anaidan/Open-Task-Light/Open Task Light/Electronics/Control Board/Control_Board/3D_Models/SMD2016.step

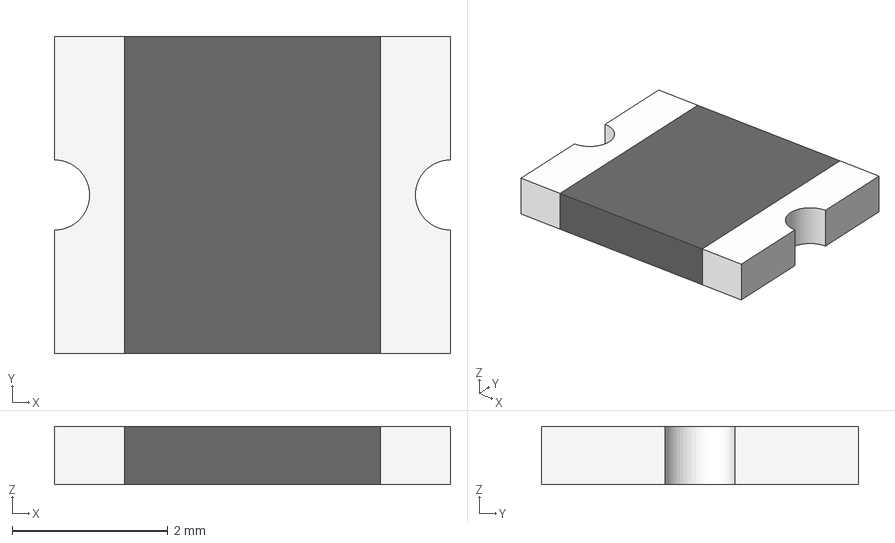
[picture p1: CAD file, 2026-11-09]
Open Task Light/Electronics/Control Board/Control_Board/3D_Models/SMD2016.step
5.08 x 4.07 x 0.75 mm
