anaidan/Open-Task-Light/Open Task Light/Electronics/Control Board/Control_Board/3D_Models/RC1206N_YAG.step

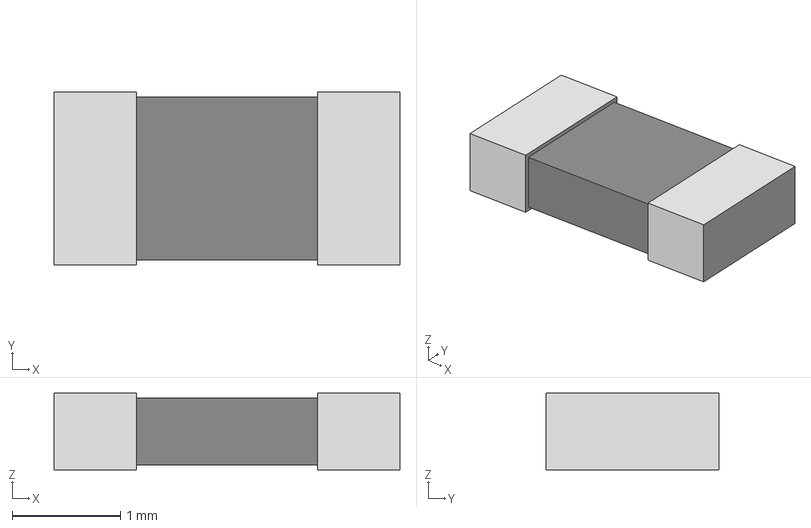
[picture p3: CAD file, 2026-10-24]
Open Task Light/Electronics/Control Board/Control_Board/3D_Models/RC1206N_YAG.step
3.20 x 1.60 x 0.711 mm
