anaidan/Open-Task-Light/Open Task Light/Electronics/Control Board/Control_Board/3D_Models/EEE-FTH101XAP.stp

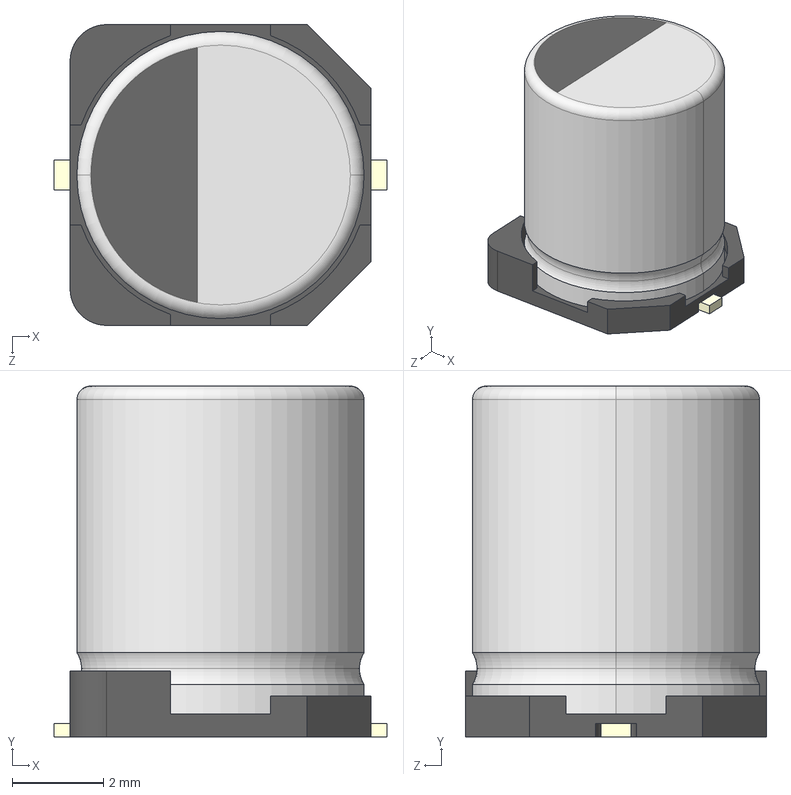
[picture p4: CAD file, 2026-10-24]
Open Task Light/Electronics/Control Board/Control_Board/3D_Models/EEE-FTH101XAP.stp
7.30 x 7.70 x 6.60 mm
標準SIZE CODE D8-001
標準SIZE CODE D8-002
標準SIZE CODE D8-003 x 2
