anaidan/Open-Task-Light/Open Task Light/Electronics/Control Board/Control_Board/3D_Models/R-78K-1.0_3D_20230223.step

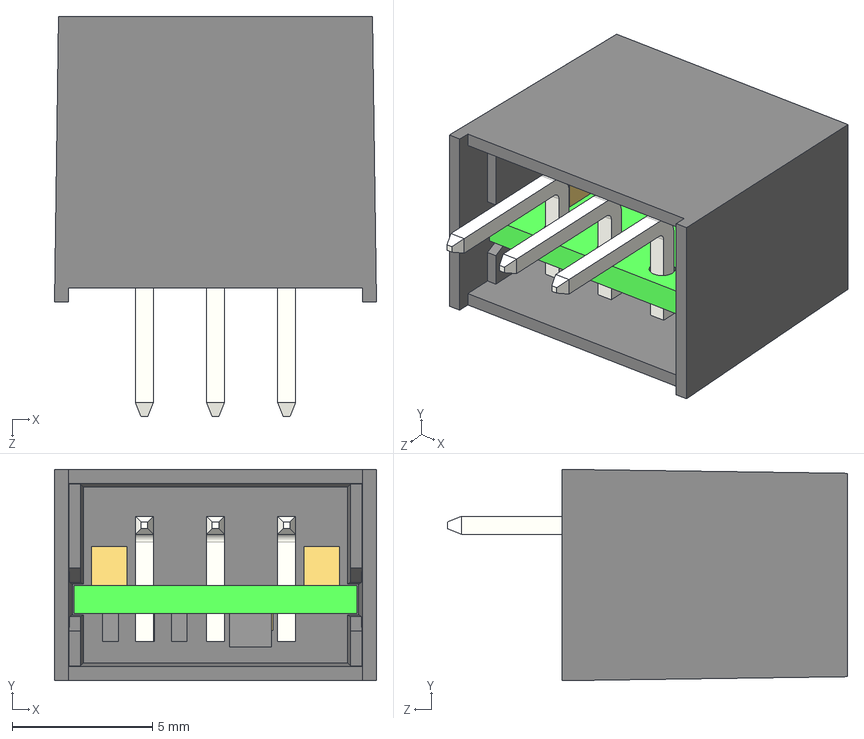
[picture p5: CAD file, 2026-10-24]
Open Task Light/Electronics/Control Board/Control_Board/3D_Models/R-78K-1.0_3D_20230223.step
11.5 x 7.55 x 14.3 mm
