anaidan/Open-Task-Light/Open Task Light/Electronics/Control Board/Control_Board/3D_Models/RCD-24-0.70VREF.stp

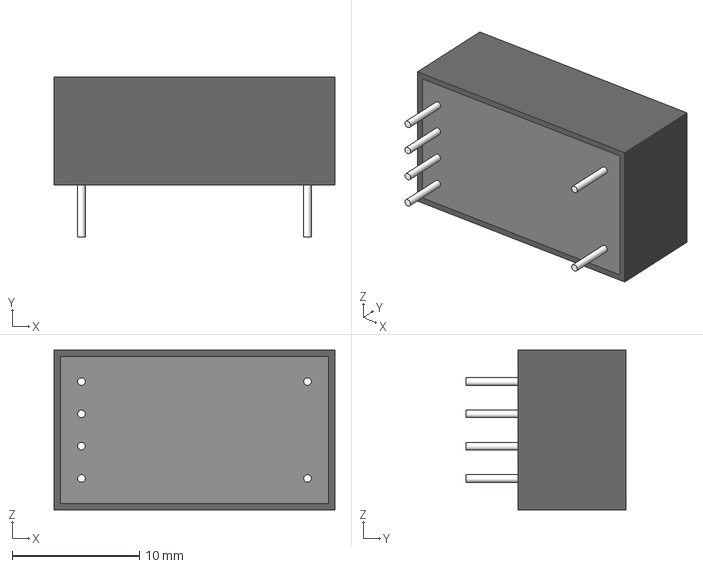
[picture p6: CAD file, 2026-10-24]
Open Task Light/Electronics/Control Board/Control_Board/3D_Models/RCD-24-0.70VREF.stp
22.1 x 12.6 x 12.6 mm
