anaidan/Open-Task-Light/Open Task Light/Electronics/Control Board/Control_Board/3D_Models/84592VEML7700.stp

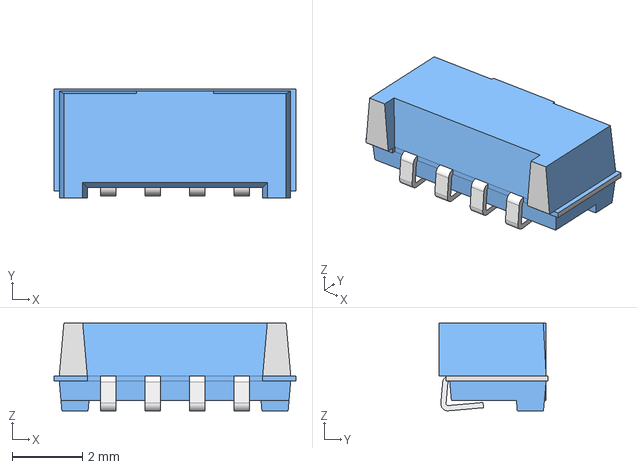
[picture p7: CAD file, 2026-10-24]
Open Task Light/Electronics/Control Board/Control_Board/3D_Models/84592VEML7700.stp
6.90 x 3.10 x 2.50 mm
