anaidan/Open-Task-Light/Open Task Light/Electronics/Control Board/Control_Board/3D_Models/2200980271.stp

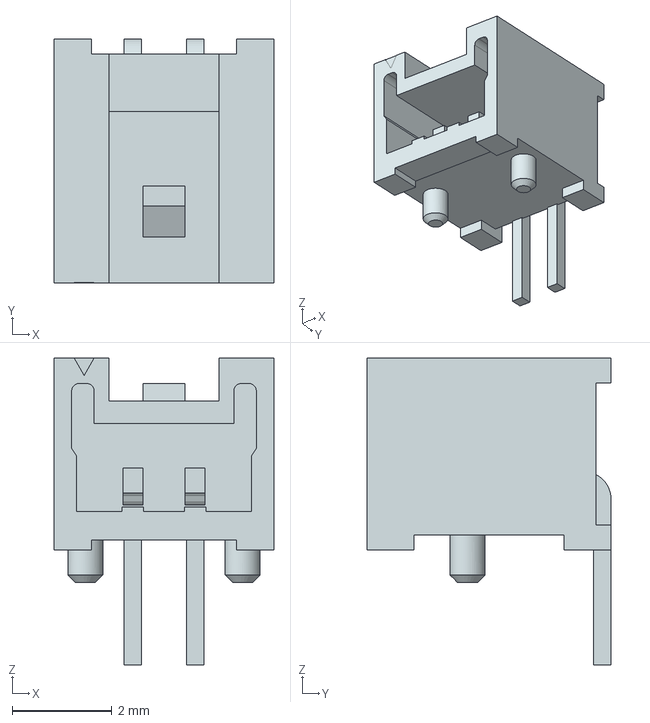
[picture p8: CAD file, 2026-10-24]
Open Task Light/Electronics/Control Board/Control_Board/3D_Models/2200980271.stp
4.40 x 4.89 x 6.15 mm
