anaidan/Open-Task-Light/Open Task Light/Electronics/Control Board/Control_Board/3D_Models/2200970271.stp

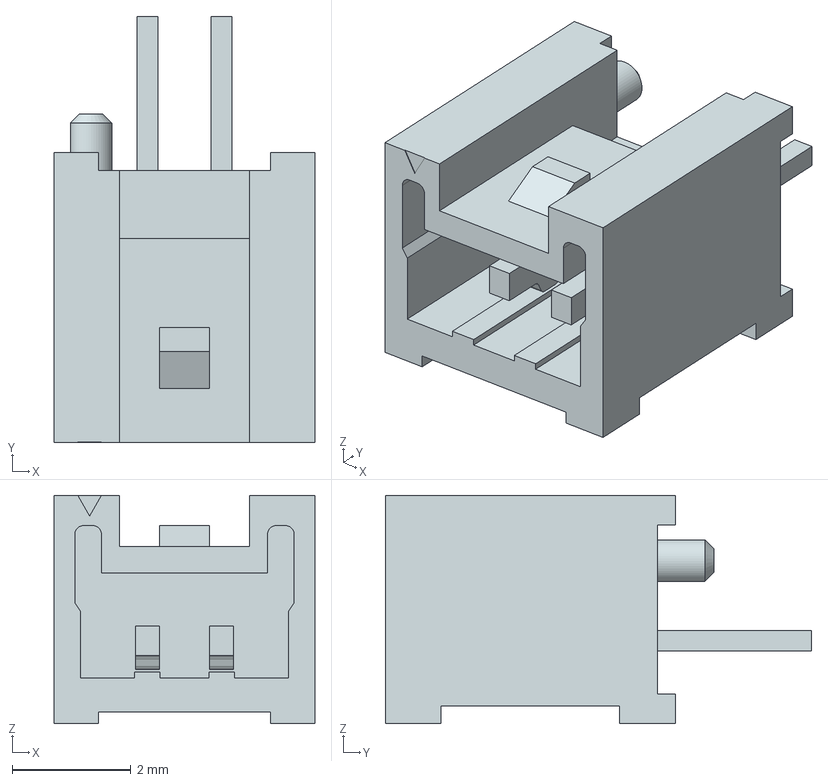
[picture p9: CAD file, 2026-10-24]
Open Task Light/Electronics/Control Board/Control_Board/3D_Models/2200970271.stp
4.40 x 7.19 x 3.85 mm
