anaidan/Open-Task-Light/Open Task Light/Electronics/Control Board/Control_Board/Control_Board.kicad_pcb

## KiCad design Open Task Light/Electronics/Control Board/Control_Board/Control_Board.kicad_pcb (2026-11-11)

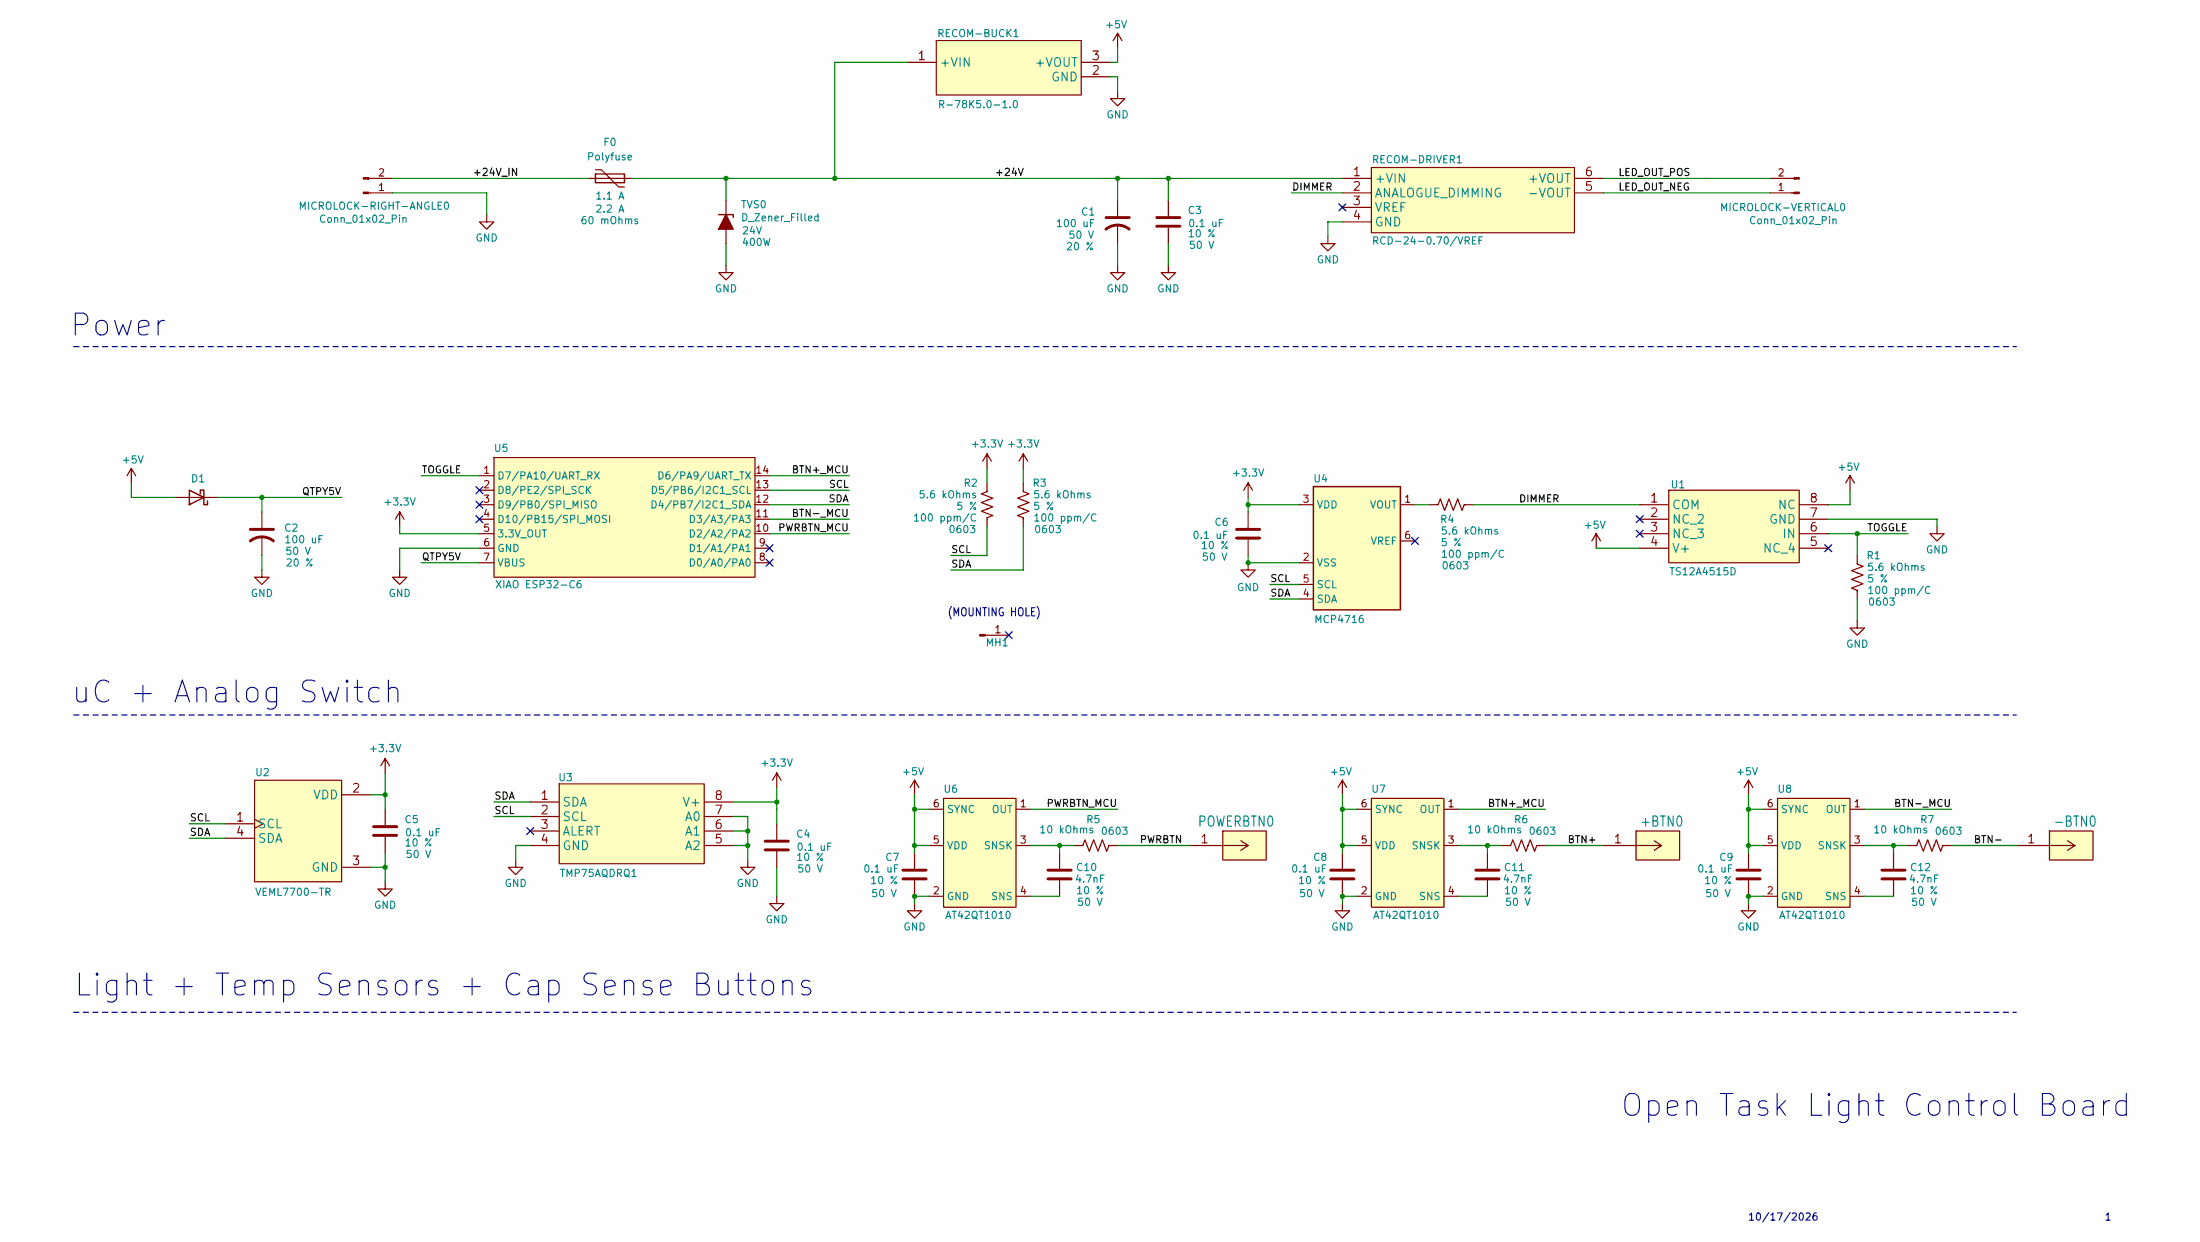
[picture p10: schematic Control_Board.kicad_sch]

Parts:
+BTN0: 807-22-001-10-001101; CONN_807-22-001-10-001101_MIM; MPN 807-22-001-10-001101
-BTN0: 807-22-001-10-001101; CONN_807-22-001-10-001101_MIM; MPN 807-22-001-10-001101
C1, C2: EEE-FTH101XAP; CAP_EEEFTH101XAP; Volage Rating 50 V; Tolerance 20 %; MPN EEE-FTH101XAP
C3, C4, C5, C6, C7, C8, C9: C; C_0603_1608Metric; Voltage Rating 50 V; Tolerance 10 %; MPN C0603C104K5RAC9109
C10, C11, C12: C; C_0603_1608Metric; Voltage Rating 50 V; Tolerance 10 %; MPN C0603C472K5RACTU
D1: 1N5819HW-7-F; D_SOD-123; MPN 1N5819HW-7-F
F0: Polyfuse; SMD2016B100TF_33; MPN SMD2016B100TF/33
MH1: 2.5MMPLATEDTHROUGHHOLE; 2.5MMPLATEDHOLE
MICROLOCK-RIGHT-ANGLE0: Conn_01x02_Pin; 2200980271; MPN 2200980271
MICROLOCK-VERTICAL0: Conn_01x02_Pin; 2200970000_A; MPN 2200970271
POWERBTN0: 807-22-001-10-001101; CONN_807-22-001-10-001101_MIM; MPN 807-22-001-10-001101
R1, R2, R3, R4: R_US; R_0603_1608Metric; Tolerance 5 %; MPN AC0603JR-075K6L
R5, R6, R7: R_US; R_0603_1608Metric; Tolerance 5 %; MPN RC0603JR-0710KL
RECOM-BUCK1: R-78K5.0-1.0; R-78K5.0-1.0_RCP; MPN R-78K5.0-1.0
RECOM-DRIVER1: RCD-24-0.70/VREF; RCD24030; MPN RCD-24-0.70/Vref
TVS0: D_Zener_Filled; SODFL3619X98N; MPN SMF4L24AT1G
U1: TS12A4515D; D8-L; MPN TS12A4515D
U2: VEML7700-TR; XDCR_VEML7700-TR; MPN VEML7700-TR
U3: TMP75AQDRQ1; D8_TEX; MPN TMP75AQDRQ1
U4: MCP4716; SOT-23-6; MPN MCP4716A3T-E/CH
U5: XIAO ESP32-C6; ESP32_C6; MPN 113991254
U6, U7, U8: AT42QT1010; SOT-23-6; MPN AT42QT1010-TSHR

Connections:
+3.3V: C4.1, C5.1, C6.1, R2.1, R3.1, U2.2 (VDD), U3.8 (V+), U4.3 (VDD), U5.5 (3.3V_OUT)
+5V: C7.1, C8.1, C9.1, D1.2 (A), RECOM-BUCK1.3 (+VOUT), U1.4 (V+), U1.8 (NC), U6.5 (VDD), U6.6 (SYNC), U7.5 (VDD), U7.6 (SYNC), U8.5 (VDD), U8.6 (SYNC)
/+24V: C1.1, C3.1, F0.2, RECOM-BUCK1.1 (+VIN), RECOM-DRIVER1.1 (+VIN), TVS0.1 (K)
/+24V_IN: F0.1, MICROLOCK-RIGHT-ANGLE0.2
/BTN+: +BTN0.1 (1_1), R6.2
/BTN+_MCU: U5.14 (D6/PA9/UART_TX), U7.1 (OUT)
/BTN-: -BTN0.1 (1_1), R7.2
/BTN-_MCU: U5.11 (D3/A3/PA3), U8.1 (OUT)
/DIMMER: R4.2, RECOM-DRIVER1.2 (ANALOGUE_DIMMING), U1.1 (COM)
/LED_OUT_NEG: MICROLOCK-VERTICAL0.1, RECOM-DRIVER1.5 (-VOUT)
/LED_OUT_POS: MICROLOCK-VERTICAL0.2, RECOM-DRIVER1.6 (+VOUT)
/PWRBTN: POWERBTN0.1 (1_1), R5.2
/PWRBTN_MCU: U5.10 (D2/A2/PA2), U6.1 (OUT)
/QTPY5V: C2.1, D1.1 (K), U5.7 (VBUS)
/SCL: R2.2, U2.1 (SCL), U3.2 (SCL), U4.5 (SCL), U5.13 (D5/PB6/I2C1_SCL)
/SDA: R3.2, U2.4 (SDA), U3.1 (SDA), U4.4 (SDA), U5.12 (D4/PB7/I2C1_SDA)
/TOGGLE: R1.1, U1.6 (IN), U5.1 (D7/PA10/UART_RX)
GND: C1.2, C2.2, C3.2, C4.2, C5.2, C6.2, C7.2, C8.2, C9.2, MICROLOCK-RIGHT-ANGLE0.1, R1.2, RECOM-BUCK1.2 (GND), RECOM-DRIVER1.4 (GND), TVS0.2 (A), U1.7 (GND), U2.3 (GND), U3.4 (GND), U3.5 (A2), U3.6 (A1), U3.7 (A0), U4.2 (VSS), U5.6 (GND), U6.2 (GND), U7.2 (GND), U8.2 (GND)
unnamed: R4.1, U4.1 (VOUT)
unnamed: C10.2, U6.4 (SNS)
unnamed: C10.1, R5.1, U6.3 (SNSK)
unnamed: C11.2, U7.4 (SNS)
unnamed: C11.1, R6.1, U7.3 (SNSK)
unnamed: C12.2, U8.4 (SNS)
unnamed: C12.1, R7.1, U8.3 (SNSK)

Notes on the sheet:
uC + Analog Switch
Power
Open Task Light Control Board
Light + Temp Sensors + Cap Sense Buttons
(MOUNTING HOLE)
10/17/2026

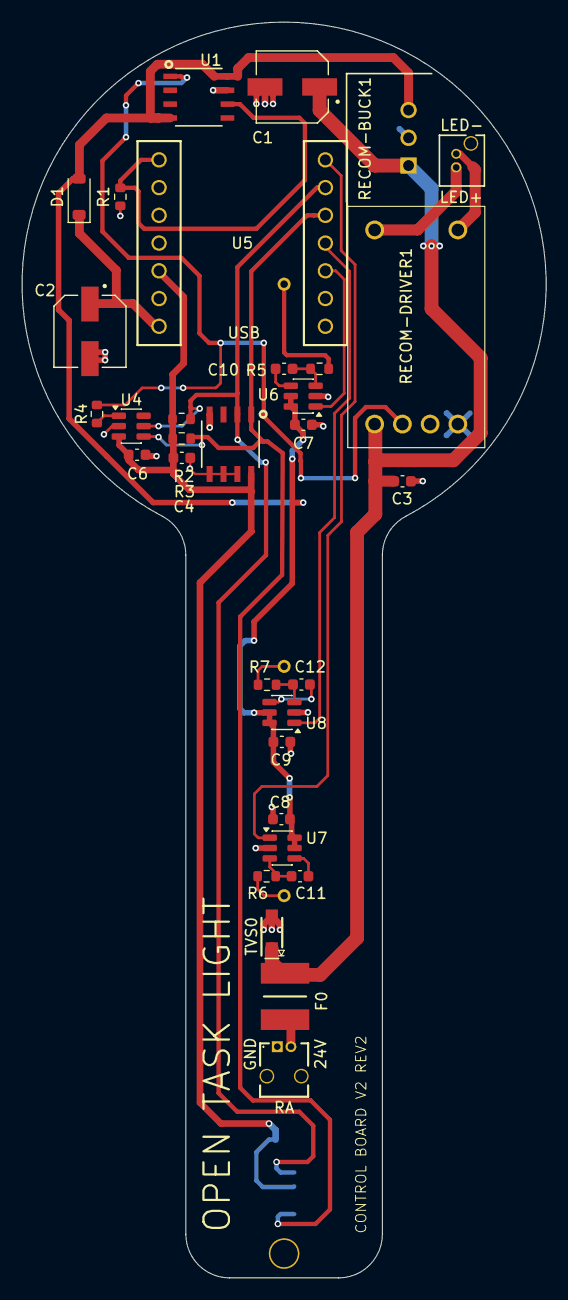
[picture p11: board Control_Board.kicad_pcb from above]

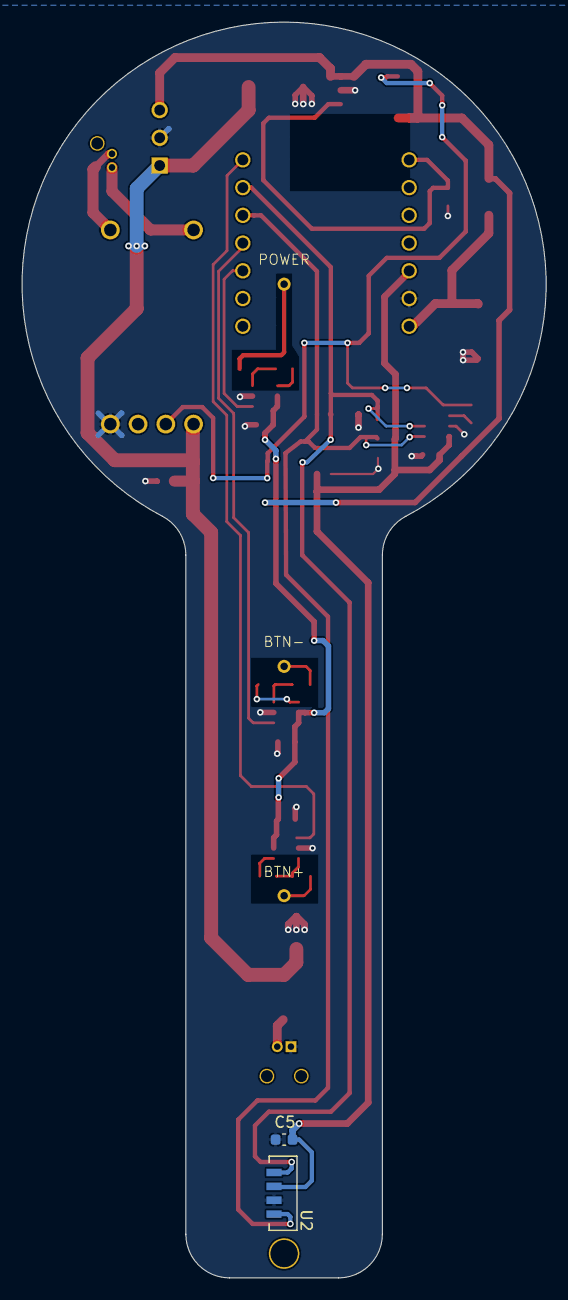
[picture p12: board Control_Board.kicad_pcb from below]

Board: 2 copper layers, 48.0 x 115.0 mm, 38 parts (5 on the bottom side), 25 nets.
