anaidan/Open-Task-Light/(commit log)

2026-10-24 kicad port for control board
    [2200970271.stp, 2200980271.stp, 84592VEML7700.stp, Control Board.brd, Control Board.sch, Control_Board.kicad_pcb, Control_Board.kicad_sch, EEE-FTH101XAP.stp]
2026-11-07 added DAC, updated analog switch startup scheme
    [Control_Board.kicad_sch]
2026-11-07 external cap sense chips added
    [Control_Board.kicad_sch]
2026-11-07 new parts placement
    [Control_Board.kicad_pcb, Control_Board.kicad_sch]
2026-11-09 3d model for ESP32 C6
    [Control_Board.kicad_pcb, Control_Board.kicad_sch, SMD2016.step, Seeed Studio XIAO ESP32-C6.step]
2026-11-09 silk clean up
    [Control_Board.kicad_pcb]
2026-11-11 better MPN/DPN
    [Control_Board.kicad_sch]
2026-11-11 standard via sizes, silk updated on some FPs to reduce DRC errors
    [Control_Board.kicad_pcb]
2026-11-11 moved DAC to 3.3V, consistent with I2C pull-ups, gnd plane cutouts for cap sense traces
    [Control_Board.kicad_pcb, Control_Board.kicad_sch]
2026-11-11 cutout under esp32 antenna
    [Control_Board.kicad_pcb, Control_Board.kicad_sch]
2026-11-11 silk tweaks
    [Control_Board.kicad_pcb]
